alnibl/ESP32_cat_follower_robot/esp32_cat_follower_improved/README.md

# ESP32 Cat Follower Robot - Улучшенная версия v2.0

## 🎯 Что изменилось

Эта версия исправляет критические проблемы, найденные при тестировании:

### ❌ Проблемы в старой версии:
1. **Блокирующие задержки** - `delay(150)` при смене направления блокировал обработку новых команд
2. **Потеря команд backward** - команды терялись во время delay
3. **Высокая латентность** - до 1663 мс вместо нормальных 100 мс
4. **Мигание зеленого LED** - перегрузка WiFi из-за необработанных запросов

### ✅ Исправления в v2.0:
1. **Неблокирующие задержки** - используется проверка `millis()` вместо `delay()`
2. **Очередь команд** - до 5 команд могут быть сохранены, если ESP32 занят
3. **Детальное логирование** - статистика выполненных/потерянных команд
4. **Новый endpoint /stats** - мониторинг состояния в реальном времени

## 📊 Результаты тестирования

**Старая версия:**
- Success rate: 88.9% (4 failed из 36)
- Средняя латентность: 99 мс
- Пики латентности: до 1929 мс
- Команды backward пропускались

**Ожидаемые результаты v2.0:**
- Success rate: 95-100%
- Средняя латентность: 60-100 мс
- Пики латентности: <200 мс
- Все команды выполняются

## 🚀 Как загрузить прошивку

### Шаг 1: Откройте Arduino IDE

1. Запустите Arduino IDE (русский интерфейс)
2. Файл → Открыть
3. Выберите: `D:\Projects\ESP32_car_cat\esp32_cat_follower_improved\esp32_cat_follower_improved.ino`

### Шаг 2: Настройте параметры платы

**Инструменты (Tools) → Плата (Board):**
- Выберите: **ESP32S3 Dev Module**

**Инструменты → USB CDC On Boot:**
- Выберите: **Enabled** ⚠️ КРИТИЧНО!

**Инструменты → PSRAM:**
- Выберите: **OPI PSRAM**

**Инструменты → Flash Size:**
- Выберите: **8MB (64Mb)**

**Инструменты → Partition Scheme:**
- Выберите: **8M with spiffs (3.6MB APP/1.5MB SPIFFS)**

**Инструменты → Upload Speed:**
- Выберите: **921600** (или 115200 если есть проблемы)

**Инструменты → USB Mode:**
- Выберите: **Hardware CDC and JTAG**

### Шаг 3: Подключите ESP32

1. Подключите ESP32-S3 к компьютеру через USB-C порт (тот что помечен "COM")
2. **Инструменты → Порт (Port)** → Выберите COM порт (обычно COM3, COM4 и т.д.)

### Шаг 4: Загрузите прошивку

1. Нажмите кнопку **Загрузить** (стрелка →) в Arduino IDE
2. Дождитесь сообщения "Подключение..." в нижней части экрана

**Если загрузка не начинается автоматически:**
1. Нажмите и **удерживайте** кнопку **BOOT** на ESP32
2. Нажмите кнопку **RST** (один раз)
3. Отпустите **RST**, затем отпустите **BOOT**
4. Нажмите **Загрузить** в Arduino IDE ещё раз

### Шаг 5: Проверьте работу

1. После загрузки откройте **Монитор порта** (Инструменты → Монитор порта)
2. Установите скорость: **115200 baud**
3. Вы должны увидеть:

```
========================================
ESP32 Cat Follower Robot v2.0 - Starting...
IMPROVED VERSION - Non-blocking delays
========================================

Connecting to WiFi: TP-Link_571B
...
CONNECTED!
IP address: 192.168.0.112

Robot is ready!
========================================
```

4. Запишите IP адрес (например, 192.168.0.112)

## 🧪 Тестирование новой прошивки

### Тест 1: Проверка в браузере

Откройте браузер и перейдите по адресу: `http://192.168.0.112/`

Вы увидите веб-интерфейс с:
- Кнопками управления
- **Статистикой команд** (новое!)

Попробуйте:
1. Forward → Backward (быстро друг за другом)
2. Forward → Stop
3. Left → Right

**Ожидаемое поведение:**
- Все команды выполняются
- Плавная смена направления с паузой 150мс
- Нет пропусков команд

### Тест 2: Проверка статистики

Откройте: `http://192.168.0.112/stats`

Вы увидите JSON с:
```json
{
  "total_commands": 15,
  "executed": 15,
  "dropped": 0,
  "queue_size": 0,
  "current_state": "STOPPED",
  "waiting_for_change": false,
  "auto_stop_enabled": false
}
```

**Хорошие показатели:**
- `dropped`: 0 или очень малое число
- `queue_size`: 0-2 (не переполнена)
- `executed` ≈ `total_commands`

### Тест 3: Serial Monitor

В Serial Monitor вы увидите детальные логи:

```
⚠️  Direction change detected! Scheduling pause (150ms)...
STOP (immediate, before direction change)
Direction change delay completed, executing pending command
Moving BACKWARD @ 150 PWM (2 sec)
```

**Обратите внимание:**
- Сообщения о смене направления
- Команды не теряются
- Очередь работает если нужно

### Тест 4: Запуск motor_test_suite.py

```bash
cd D:\Projects\ESP32_car_cat
cat_env\Scripts\activate
python motor_test_suite.py
```

Выберите режим **5 (Фаза 5: Тесты последовательностей)**

**Ожидаемые результаты:**
- ✅ Test forward→backward: PASS
- ✅ Test emergency stop: PASS
- ✅ Test complex maneuvers: PASS
- Dropped commands: 0

## 📈 Мониторинг в реальном времени

### Через Serial Monitor

В Serial Monitor каждые 30 секунд выводится статистика:

```
========== STATISTICS ==========
Total commands received: 42
Executed commands: 42
Dropped commands: 0
Queue size: 0
Drop rate: 0.00%
================================
```

### Через Web интерфейс

Обновите главную страницу `http://192.168.0.112/`:
- **Total commands**: общее количество
- **Executed**: выполнено
- **Dropped**: потеряно
- **Queue**: размер очереди (0-5)

## 🔧 Новые возможности

### 1. Очередь команд

Если команды приходят быстрее чем ESP32 успевает их выполнить, они сохраняются в очередь (до 5 команд).

**Пример:**
```
Команда 1: forward → выполняется
Команда 2: backward → в очереди (ждет паузы 150мс)
Команда 3: left → в очереди
```

Когда пауза завершена, команды выполняются по порядку.

### 2. Endpoint /stats

**GET** `http://192.168.0.112/stats`

Возвращает JSON с текущим состоянием:
- Количество команд
- Состояние моторов
- Флаги ожидания
- Размер очереди

**Использование в Python:**
```python
import requests

response = requests.get("http://192.168.0.112/stats")
stats = response.json()

print(f"Dropped commands: {stats['dropped']}")
print(f"Current state: {stats['current_state']}")
```

### 3. Улучшенный /command endpoint

Теперь возвращает дополнительную информацию:

```json
{
  "status": "ok",
  "action": "forward",
  "speed": 150,
  "queue": 0,
  "dropped": 0
}
```

## ⚠️ Важные примечания

1. **Не удаляйте старую версию** - держите `esp32_cat_follower_simple` как backup
2. **WiFi настройки** - проверьте SSID и пароль в строках 12-13
3. **Пины** - не меняйте GPIO пины без необходимости
4. **Serial Monitor** - используйте для диагностики проблем

## 🐛 Решение проблем

### Команды все равно теряются

Проверьте в Serial Monitor:
```
⚠️  Command queue FULL! Dropping command.
```

**Решение:** Увеличьте `COMMAND_QUEUE_SIZE` в коде (строка 40):
```cpp
const int COMMAND_QUEUE_SIZE = 10;  // Было 5
```

### Высокая латентность

Проверьте `/stats`:
- Если `queue_size` часто = 5 → очередь переполняется
- Если `waiting_for_change` = true долгое время → проблема с таймером

**Решение:** Уменьшите частоту команд в Python (увеличьте `COMMAND_INTERVAL`)

### ESP32 перезагружается

Проверьте питание:
- PowerBank должен выдавать **минимум 2A**
- Проверьте все GND подключения
- Убедитесь что конденсаторы припаяны к повышающему преобразователю

## 📊 Сравнение версий

| Параметр | v1.0 (старая) | v2.0 (новая) |
|---|---|---|
| Блокирующие delay | ✅ Да (150мс) | ❌ Нет |
| Очередь команд | ❌ Нет | ✅ Да (5 команд) |
| Статистика | ❌ Нет | ✅ Да |
| Success rate | 88.9% | 95-100% (ожидается) |
| Потеря backward | ✅ Да | ❌ Нет |
| Endpoint /stats | ❌ Нет | ✅ Да |
| Логирование | Базовое | Детальное |

## 🎉 Что дальше?

После успешной загрузки v2.0:

1. **Запустите полный тест:**
   ```bash
   python motor_test_suite.py
   # Выберите режим 1 (Полный набор)
   ```

2. **Сравните результаты** с предыдущим отчетом:
   - Success rate должен быть >95%
   - Dropped commands ≈ 0
   - Все тесты последовательностей PASS

3. **Запустите cat_follower_yolo11.py** для тестирования с реальным котом!

---

**Версия:** 2.0
**Дата:** 2025-12-02
**Автор:** Улучшения на основе анализа отчета тестирования
