alnibl/ESP32_cat_follower_robot/esp32_cat_follower_improved/UPDATE_WEB_INTERFACE.md

# Обновление веб-интерфейса v2.1

## 🎯 Что изменилось

Заменен старый веб-интерфейс со ссылками на **современный с AJAX кнопками**!

### Проблема (старая версия):
```
❌ Нажимаете "Move Forward" → страница перезагружается
❌ Показывается только текст "Moving forward"
❌ Нужно нажимать "Назад" в браузере
❌ Невозможно быстро отправлять команды
```

### Решение (новая версия):
```
✅ Нажимаете кнопку → команда отправляется БЕЗ перезагрузки
✅ Страница остается открытой
✅ Статистика обновляется автоматически каждые 2 секунды
✅ Можно быстро нажимать команды подряд!
```

---

## 🚀 Новые возможности

### 1. **AJAX кнопки** (без перезагрузки страницы)
- Кнопки используют JavaScript `fetch()` API
- Отправляют запросы на `/command?action=forward&speed=150`
- Страница НЕ перезагружается!

### 2. **Live обновление статистики**
- Статистика обновляется каждые 2 секунды автоматически
- Не нужно обновлять страницу (F5)
- Видите изменения в реальном времени!

### 3. **Визуальная обратная связь**
```
✅ Sent: FORWARD @ 150 PWM
```
После каждой команды показывается подтверждение.

### 4. **Современный дизайн**
- Крупные цветные кнопки
- Grid layout (3x3) для удобства
- Эмодзи для каждой команды:
  - ⬆️ Forward (зеленая)
  - ⬇️ Backward (красная)
  - ⬅️ Left (оранжевая)
  - ➡️ Right (синяя)
  - ⏹️ Stop (серая)

### 5. **Адаптивный дизайн**
- Работает на телефоне и планшете
- Responsive layout (max-width: 600px)
- Viewport meta tag для мобильных устройств

---

## 📸 Как выглядит новый интерфейс

```
╔════════════════════════════════════════╗
║  🤖 ESP32 Cat Robot v2.1               ║
║  ✅ BUGFIX: Queue processing fixed!    ║
║  IP: 192.168.0.112 | Speed: 150 PWM   ║
║                                        ║
║  Ready to control...                   ║
║                                        ║
║  ┌──────────┬──────────┬──────────┐   ║
║  │          │ ⬆️       │          │   ║
║  │          │ Forward  │          │   ║
║  │          │ (1.5s)   │          │   ║
║  ├──────────┼──────────┼──────────┤   ║
║  │ ⬅️       │          │ ➡️       │   ║
║  │ Left     │          │ Right    │   ║
║  │ (0.4s)   │          │ (0.4s)   │   ║
║  ├──────────┼──────────┼──────────┤   ║
║  │          │ ⬇️       │          │   ║
║  │          │ Backward │          │   ║
║  │          │ (1.5s)   │          │   ║
║  ├──────────┴──────────┴──────────┤   ║
║  │      ⏹️ STOP                   │   ║
║  └─────────────────────────────────┘   ║
║                                        ║
║  📊 Statistics (Auto-refresh)          ║
║  Total commands: 15                    ║
║  ├─ Executed: 15                       ║
║  ├─ Queued: 10                         ║
║  ├─ Dropped: 0 ✅                      ║
║  └─ In queue now: 0/5                  ║
║  Motor state: STOPPED                  ║
╚════════════════════════════════════════╝
```

---

## 🔄 Как обновить прошивку

### Шаг 1: Загрузите обновленную прошивку

```
1. Arduino IDE → Открыть:
   D:\Projects\ESP32_car_cat\esp32_cat_follower_improved\esp32_cat_follower_improved.ino

2. Настройки платы (как обычно):
   - ESP32S3 Dev Module
   - USB CDC On Boot: Enabled

3. Загрузить (стрелка →)
```

### Шаг 2: Откройте новый интерфейс

```
1. Откройте браузер: http://192.168.0.112/

2. Вы увидите новый интерфейс с кнопками!
```

### Шаг 3: Протестируйте

```
Быстро нажмите несколько команд подряд:
1. Forward
2. Left
3. Forward
4. Right
5. Stop

Страница НЕ перезагружается!
Статистика обновляется автоматически!
```

---

## 🧪 Как работают AJAX кнопки

### Техническое описание:

```javascript
// При нажатии кнопки:
function sendCommand(action) {
  // 1. Отправляем запрос БЕЗ перезагрузки страницы
  fetch('/command?action=' + action + '&speed=150')
    .then(r => r.json())
    .then(data => {
      // 2. Показываем подтверждение
      document.getElementById('lastCommand').textContent =
        '✅ Sent: ' + action.toUpperCase();

      // 3. Обновляем статистику
      updateStats();
    });
}

// Автоматическое обновление статистики каждые 2 секунды:
setInterval(updateStats, 2000);
```

### Преимущества:
- ✅ Страница остается открытой
- ✅ Можно быстро нажимать команды
- ✅ Видите результаты в реальном времени
- ✅ Работает как мобильное приложение!

---

## 📊 Сравнение старого и нового интерфейса

| Функция | Старый (ссылки) | Новый (AJAX кнопки) |
|---|---|---|
| **Перезагрузка страницы** | ❌ Да (каждый раз) | ✅ Нет |
| **Быстрые команды** | ❌ Невозможно | ✅ Да |
| **Обновление статистики** | ❌ Вручную (F5) | ✅ Авто (2 сек) |
| **Визуальная обратная связь** | ❌ Нет | ✅ Да |
| **Дизайн** | ❌ Простой список | ✅ Крупные кнопки |
| **Мобильная версия** | ❌ Нет | ✅ Да |
| **Цветовая индикация** | ❌ Нет | ✅ Да |
| **Эмодзи** | ⚠️ Частично | ✅ Везде |

---

## 🎯 Тестирование очереди команд (теперь легко!)

### Быстрый тест очереди:

```
1. Откройте: http://192.168.0.112/

2. БЫСТРО нажмите (без пауз):
   - Forward
   - Forward
   - Left
   - Right
   - Stop

3. Наблюдайте за статистикой в реальном времени!

   Вы увидите как:
   - Total commands увеличивается
   - Queued растет (команды добавляются в очередь)
   - In queue now меняется (очередь обрабатывается)
   - Dropped остается 0 ✅
```

### Ожидаемый результат:

```
📊 Statistics (Auto-refresh)
Total commands: 5
├─ Executed: 5
├─ Queued: 4        ← 4 команды попали в очередь!
├─ Dropped: 0 ✅    ← Нет потерь!
└─ In queue now: 0/5 ← Все выполнено
Motor state: STOPPED
```

**Теперь вы можете легко протестировать очередь!** 🎉

---

## 🐛 Возможные проблемы

### Проблема 1: Старый интерфейс всё ещё показывается

**Причина:** Браузер кэширует старую HTML страницу.

**Решение:**
```
1. Очистите кэш браузера:
   - Chrome/Edge: Ctrl+Shift+Delete
   - Или просто: Ctrl+F5 (жесткое обновление)

2. Или откройте в режиме инкогнито:
   - Chrome/Edge: Ctrl+Shift+N
```

### Проблема 2: Кнопки не отправляют команды

**Причина:** JavaScript отключен или ошибка в консоли.

**Решение:**
```
1. Откройте консоль браузера: F12
2. Перейдите на вкладку "Console"
3. Посмотрите есть ли ошибки (красным цветом)
4. Если есть - пришлите скриншот
```

### Проблема 3: Статистика не обновляется автоматически

**Причина:** Endpoint `/stats` не отвечает.

**Решение:**
```
1. Проверьте вручную: http://192.168.0.112/stats
2. Должен вернуться JSON
3. Если нет - проверьте Serial Monitor
```

---

## 📱 Использование с телефона/планшета

Новый интерфейс отлично работает на мобильных устройствах!

### Как подключиться:

```
1. Убедитесь что телефон подключен к той же WiFi сети
   (TP-Link_571B)

2. Откройте браузер на телефоне

3. Введите: http://192.168.0.112/

4. Добавьте на главный экран (опционально):
   - Android Chrome: Меню → "Добавить на главный экран"
   - iOS Safari: Поделиться → "На экран Домой"

5. Теперь можно управлять роботом с телефона!
```

### Преимущества мобильного управления:

- ✅ Ходите с телефоном рядом с роботом
- ✅ Крупные кнопки удобны для пальцев
- ✅ Видите статистику в реальном времени
- ✅ Не нужен ноутбук!

---

## 🎯 Следующие шаги

После обновления интерфейса:

1. **Протестируйте очередь команд:**
   ```
   Быстро нажмите 5-10 команд подряд
   Проверьте что Queued > 0
   Проверьте что Dropped = 0
   ```

2. **Запустите полное тестирование:**
   ```bash
   python motor_test_suite.py
   ```

3. **Попробуйте управление с телефона:**
   ```
   Откройте http://192.168.0.112/ на телефоне
   Ходите с роботом, управляя с телефона!
   ```

4. **Запустите мониторинг:**
   ```bash
   python monitor_stats.py
   ```
   На ноутбуке будет live статистика, пока вы управляете с телефона!

---

## ✨ Бонус: Горячие клавиши (планируется в v2.2)

В будущей версии можно добавить управление с клавиатуры:

```javascript
// Пример (не реализовано пока):
document.addEventListener('keydown', (e) => {
  if (e.key === 'ArrowUp') sendCommand('forward');
  if (e.key === 'ArrowDown') sendCommand('backward');
  if (e.key === 'ArrowLeft') sendCommand('left');
  if (e.key === 'ArrowRight') sendCommand('right');
  if (e.key === ' ') sendCommand('stop');
});
```

Если нужно - скажите, добавлю!

---

**Обновляйте прошивку и наслаждайтесь удобным интерфейсом!** 🚀

Теперь вы можете быстро тестировать очередь команд без необходимости нажимать "Назад" в браузере!
