alnibl/ESP32_cat_follower_robot/BENCHMARK_GUIDE.md

# Руководство по бенчмарку YOLO11 на Intel i5-1235U

## Зачем нужен бенчмарк?

Ваш процессор **Intel i5-1235U** поддерживает технологию **OpenVINO** - оптимизацию для нейронных сетей от Intel.

**OpenVINO может ускорить YOLO11 в 1.5-3 раза** на процессорах Intel!

---

## Что делает скрипт benchmark_models.py?

1. **Захватывает 50 кадров** с вашей IP камеры
2. **Тестирует PyTorch модель** (yolo11n.pt) - стандартная версия
3. **Экспортирует в OpenVINO** - конвертирует модель в формат для Intel процессоров
4. **Тестирует OpenVINO модель** - оптимизированная версия
5. **Сравнивает результаты** - показывает какая модель быстрее

---

## Как запустить бенчмарк?

### Шаг 1: Установить OpenVINO

```bash
# Активировать окружение
source cat_env/Scripts/activate

# Установить OpenVINO
pip install openvino
```

### Шаг 2: Настроить config.py

Убедитесь что указан правильный CAMERA_URL:

```python
CAMERA_URL = "rtsp://192.168.0.162:554/stream"  # ← Ваша камера
```

### Шаг 3: Запустить бенчмарк

```bash
python benchmark_models.py
```

---

## Что вы увидите?

### Вывод в консоли:

```
🏁 БЕНЧМАРК: YOLO11 PyTorch vs OpenVINO
============================================================

Процессор: Intel i5-1235U
Модель: yolo11n.pt
Разрешение: 640x480
Количество тестовых кадров: 50

📹 Подключение к камере: rtsp://192.168.0.162:554/stream
✅ Камера подключена!

📸 Захват 50 тестовых кадров...
   Захвачено 10/50 кадров
   Захвачено 20/50 кадров
   ...
✅ Захвачено 50 кадров

============================================================
🧪 Тестирование: YOLO11 PyTorch (.pt)
============================================================
⏳ Загрузка модели: yolo11n.pt
✅ Модель загружена успешно!
🔥 Прогрев модели (5 кадров)...
⚡ Запуск бенчмарка на 50 кадрах...
   Кадр 10/50 | Время: 118.5мс | FPS: 8.4
   Кадр 20/50 | Время: 117.2мс | FPS: 8.5
   ...

============================================================
📊 РЕЗУЛЬТАТЫ: YOLO11 PyTorch (.pt)
============================================================
  Обработано кадров:        50
  Общее время:              5.88 сек
  Детектировано котов:      12

  Среднее время инференса:  117.60 мс
  Минимальное время:        112.30 мс
  Максимальное время:       125.40 мс
  Стандартное отклонение:   3.50 мс

  ⚡ Средний FPS:            8.50 fps
============================================================

============================================================
🔄 ЭКСПОРТ В OPENVINO
============================================================
⏳ Загрузка модели: yolo11n.pt
⏳ Экспорт в формат OpenVINO...
   (Это может занять 1-2 минуты при первом запуске)
✅ Экспорт завершён успешно!
📁 Путь к модели OpenVINO: yolo11n_openvino_model
============================================================

============================================================
🧪 Тестирование: YOLO11 OpenVINO
============================================================
⏳ Загрузка модели: yolo11n_openvino_model
✅ Модель загружена успешно!
🔥 Прогрев модели (5 кадров)...
⚡ Запуск бенчмарка на 50 кадрах...
   Кадр 10/50 | Время: 66.2мс | FPS: 15.1
   Кадр 20/50 | Время: 65.5мс | FPS: 15.3
   ...

============================================================
📊 РЕЗУЛЬТАТЫ: YOLO11 OpenVINO
============================================================
  Обработано кадров:        50
  Общее время:              3.29 сек
  Детектировано котов:      12

  Среднее время инференса:  65.80 мс
  Минимальное время:        62.10 мс
  Максимальное время:       71.20 мс
  Стандартное отклонение:   2.20 мс

  ⚡ Средний FPS:            15.20 fps
============================================================

============================================================
📊 СРАВНЕНИЕ РЕЗУЛЬТАТОВ
============================================================

Модель                    FPS            Время (мс)
------------------------------------------------------------
PyTorch (.pt)             8.50           117.60
OpenVINO                  15.20          65.80
------------------------------------------------------------

⚡ Ускорение OpenVINO:      1.79x
⏱️  Снижение времени:       44.0%

============================================================
💡 РЕКОМЕНДАЦИЯ
============================================================
✅ OpenVINO значительно быстрее (1.79x)!
   Рекомендуется использовать для вашего робота.

   Обновите config.py:
   YOLO_MODEL = "yolo11n_openvino_model"
============================================================
```

---

## Как использовать результаты?

### Если OpenVINO быстрее (обычно так и есть):

1. Откройте `config.py`
2. Измените строку:

```python
# Было:
YOLO_MODEL = "yolo11n.pt"

# Стало (используйте путь из вывода бенчмарка):
YOLO_MODEL = "yolo11n_openvino_model"
```

3. Теперь все скрипты будут использовать быструю OpenVINO версию!

---

## Типичные результаты на Intel i5-1235U

### Ожидаемое ускорение:

| Модель | FPS (640x480) | Время инференса |
|---|---|---|
| PyTorch (.pt) | 7-10 fps | 100-140 мс |
| OpenVINO | 12-18 fps | 55-80 мс |
| **Ускорение** | **1.5-2.0x** | **30-50% быстрее** |

---

## Решение проблем

### Ошибка: "openvino not found"

```bash
pip install openvino
```

### Ошибка при экспорте: "Permission denied"

Запустите VS Code от имени администратора или измените папку проекта.

### Низкий FPS на обеих моделях (<5 fps)

1. Уменьшите разрешение в config.py:
   ```python
   FRAME_WIDTH = 416
   FRAME_HEIGHT = 416
   ```

2. Закройте другие программы

3. Проверьте что камера даёт хороший поток (10 FPS)

---

## После бенчмарка

Теперь можете запускать робота с оптимизированной моделью:

```bash
# Тест детекции
python test_detection.py

# Полный запуск
python cat_follower_yolo11.py
```

Модель из `YOLO_MODEL` в config.py будет использоваться автоматически!

---

## Дополнительная оптимизация

### Если хотите ещё больше скорости:

1. **Уменьшите разрешение**:
   ```python
   FRAME_WIDTH = 416
   FRAME_HEIGHT = 416
   ```

2. **Используйте INT8 квантизацию** (для продвинутых):
   ```python
   model.export(format='openvino', int8=True)
   ```

3. **Уменьшите confidence threshold** (меньше обработки):
   ```python
   CONFIDENCE_THRESHOLD = 0.6  # было 0.5
   ```

---

**Удачи с бенчмарком! 🚀**
