alnibl/ESP32_cat_follower_robot/TEST_REPORT_20251202_171003.md

# Отчет о тестировании моторов ESP32
## Робот следящий за котом

**Дата/Время:** 2025-12-02 17:29:44
**Session ID:** 20251202_171003
**ESP32 IP:** 192.168.0.112

---

## 📊 Сводка результатов

| Метрика | Значение |
|---|---|
| **Всего тестов** | 36 |
| **Успешно** | 32 (88.9%) |
| **Провалено** | 4 |

---

## 🎯 Рекомендации для config.py

На основе проведенных тестов рекомендуется обновить следующие параметры:

```python
# ========== РЕЗУЛЬТАТЫ КАЛИБРОВКИ ==========
# Calibration Results from motor_test_suite.py
# Дата тестирования: 2025-12-02

# Рекомендуемые скорости (проверены тестами):
SPEED_FORWARD_FAST = 200   # ✅ Стабильно
SPEED_FORWARD_SLOW = 150   # ✅ Плавно
SPEED_TURN_FAST = 200
SPEED_TURN_SLOW = 150
SPEED_SEARCH = 180
SPEED_BACKWARD = 200

# Минимальный безопасный интервал между командами:
COMMAND_INTERVAL = 0.7     # ✅ Протестировано
```

---

## 📁 Файлы с результатами

- **CSV данные:** test_results_20251202_171003.csv
- **JSON отчет:** test_report_20251202_171003.json

---

**Дата отчета:** 2025-12-02
**Генератор:** Motor Test Suite v1.0
