alnibl/ESP32_cat_follower_robot/test_results_20251202_171003.csv

timestamp | category | phase | direction | speed_pwm | duration_target_ms | duration_actual_ms | latency_ms | success | moved | distance_cm | quality_score | notes | test_id
2025-12-02T17:10:03.860711 | connection | 1 | N/A | 0 | 0 | 0 | 359.26 | True | N/A | N/A | N/A | ESP32 responded with HTTP 200 | 1
2025-12-02T17:11:33.599433 | pwm_calibration | 1 | forward | 115 | 1000 | 2000 | 0 | True | True | N/A | N/A | Minimum PWM found: 115 | 2
2025-12-02T17:11:37.642562 | latency | 2 | N/A | 0 | 0 | 0 | 96.67 | False | N/A | N/A | N/A | Network RTT: avg=96.67ms, min=69.47ms, max=132.45ms | 3
2025-12-02T17:11:41.749923 | latency | 2 | N/A | 0 | 0 | 0 | 101.33 | True | N/A | N/A | N/A | Command latency: avg=101.33ms, success_rate=100.0% | 4
2025-12-02T17:13:56.996825 | latency | 2 | forward | 200 | 0 | 0 | 0 | False | False | N/A | N/A | No data collected | 5
2025-12-02T17:15:19.128241 | duration | 3 | forward | 150 | 250 | 2000 | 107.41 | True | True | 0 | 5 |  | 6
2025-12-02T17:16:07.705295 | duration | 3 | forward | 150 | 500 | 2000 | 312.95 | True | True | 0 | 5 |  | 7
2025-12-02T17:16:44.002007 | duration | 3 | forward | 150 | 750 | 2000 | 88.9 | True | True | 30.0 | 5 | 5 | 8
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
