alnibl/ESP32_cat_follower_robot/test_results_20251202_181247.csv

timestamp | category | phase | direction | speed_pwm | duration_target_ms | duration_actual_ms | latency_ms | success | moved | distance_cm | quality_score | notes | test_id
2025-12-02T18:12:47.405457 | connection | 1 | N/A | 0 | 0 | 0 | 342.27 | True | N/A | N/A | N/A | ESP32 responded with HTTP 200 | 1
2025-12-02T18:14:54.070755 | pwm_calibration | 1 | forward | 136 | 1000 | 2000 | 0 | True | True | N/A | N/A | Minimum PWM found: 136 | 2
2025-12-02T18:14:58.217798 | latency | 2 | N/A | 0 | 0 | 0 | 102.03 | False | N/A | N/A | N/A | Network RTT: avg=102.03ms, min=81.68ms, max=131.99ms | 3
2025-12-02T18:15:02.302149 | latency | 2 | N/A | 0 | 0 | 0 | 97.87 | True | N/A | N/A | N/A | Command latency: avg=97.87ms, success_rate=100.0% | 4
2025-12-02T18:16:53.881401 | latency | 2 | forward | 200 | 0 | 0 | 500.0 | True | True | N/A | N/A | Motor response time (visual): avg=500.0ms | 5
2025-12-02T18:17:04.899824 | duration | 3 | forward | 150 | 250 | 2000 | 115.94 | False | False | 0 | 0 | Робот не двигался | 6
2025-12-02T18:17:30.976390 | duration | 3 | forward | 150 | 500 | 2000 | 62.75 | True | True | 40.0 | 4 |  | 7
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
