alnibl/ESP32_cat_follower_robot/FIX_TIMING.md

# Исправление проблемы с таймингом команд

## Проблема

Робот "пищал" и стоял на месте, потому что:

1. **Команды отправлялись слишком часто** (каждые 300мс)
2. **ESP32 не успевал выполнять команды** (таймеры на 500мс)
3. **Компенсация дрейфа мешала** (скорость 18 = 7% от макс - мотор не запускался)

### Что происходило:

```
0мс:    Команда RIGHT (компенсация, скорость 18) → ESP32 начал таймер 500мс
300мс:  Команда FORWARD (скорость 120) → ESP32 прервал предыдущую, начал новый таймер
600мс:  Команда LEFT (поиск) → ESP32 прервал, новый таймер
...
```

**Результат:** Моторы постоянно прерывались, робот пищал (команды приходили) но не двигался.

---

## Решение

### 1. Отключена компенсация дрейфа (временно)

```python
# config.py
DRIFT_COMPENSATION = 0.0  # было 0.15
```

**Почему:** Упрощает логику, убирает лишние команды

---

### 2. Увеличен интервал команд

```python
# config.py
COMMAND_INTERVAL = 0.7  # было 0.3
```

**Почему:**
- ESP32 имеет таймеры на 500мс
- Нужен запас времени для выполнения команды
- 700мс = 500мс на выполнение + 200мс запас

---

### 3. Упрощён режим поиска

**Было:**
```
Цикл 3 секунды:
- 1 сек: поворот
- 1 сек: пауза
- 1 сек: вперёд
```

**Стало:**
```
Всё время: медленный поворот на месте
```

**Почему:** Проще, стабильнее, робот просто крутится пока не найдёт кота

---

## Новый алгоритм работы

### Временная диаграмма:

```
Время:      0с      0.7с    1.4с    2.1с    2.8с
Кадр:       #1      #3      #5      #7      #9
Обработка:  ✅      ✅      ✅      ✅      ✅
Команда:    LEFT → ESP32 → STOP → LEFT → LEFT
            ↓      выполняет     ↓      ↓
           500мс   команду     500мс  500мс
           поворот             поворот
```

**Робот:**
1. Детектирует кота каждые ~200мс (каждый 2-й кадр)
2. Принимает решение
3. Отправляет команду ESP32 **раз в 700мс**
4. ESP32 **успевает выполнить** команду за 500мс
5. Через 700мс приходит следующая команда

---

## Что должно работать теперь

### Режим поиска (кота нет):
- Робот медленно поворачивается влево/вправо
- Каждые 3 секунды меняет направление
- Команды идут каждые 700мс
- Нет рывков, плавное вращение

### Когда кот найден:
```
🐱 Кот детектирован! Размер bbox: 191x268
↔️  Кот на оптимальном расстоянии но сбоку (отклонение 222px)
📡 Команда отправлена: right (скорость: 150)
   ↓
ESP32 поворачивает вправо 500мс
   ↓
700мс спустя → следующая команда
```

---

## Параметры для тонкой настройки

### Если робот слишком медленно реагирует:

```python
COMMAND_INTERVAL = 0.6  # Быстрее (минимум 0.6 сек!)
```

### Если робот дёргается:

```python
COMMAND_INTERVAL = 0.8  # Медленнее, плавнее
```

### Если хотите вернуть режим патруля (вперёд + поворот):

Откатите изменения в `cat_follower_yolo11.py` функции `search_mode()`

---

## Важно!

**Не делайте COMMAND_INTERVAL меньше 0.6 секунды!**

Иначе команды будут снова прерывать друг друга:
- ESP32 таймер = 500мс
- Нужен запас = минимум 100мс
- Итого минимум = 600мс = 0.6 сек

---

## Тестирование

Запустите снова:

```bash
python cat_follower_yolo11.py
```

**Ожидаемое поведение:**

1. **Без кота:**
   - Робот медленно крутится на месте
   - Раз в 700мс слышен короткий "пи" (команда отправлена)
   - Видно плавное вращение

2. **С котом:**
   - Робот поворачивается к коту
   - Едет вперёд если кот далеко
   - Останавливается на оптимальном расстоянии
   - Движения плавные, без рывков

---

## Следующие улучшения

После того как всё заработает стабильно, можно:

1. **Вернуть компенсацию дрейфа** (но с бОльшим коэффициентом ~0.5)
2. **Добавить плавное ускорение** (постепенно увеличивать скорость)
3. **Сглаживание детекций** (усреднять положение кота за несколько кадров)

Но сначала - стабильная базовая работа! 🎯
