alnibl/ESP32_cat_follower_robot/test_detection.py

"""
Тестовый скрипт для проверки детекции кота с YOLO11
Test script for cat detection with YOLO11 (no motor control)
"""

from cat_follower_yolo11 import CatFollowerYOLO11

if __name__ == "__main__":
    print("\n" + "="*60)
    print("🧪 ТЕСТОВЫЙ РЕЖИМ: Проверка детекции YOLO11")
    print("="*60)
    print("\nЭтот скрипт:")
    print("  ✅ Подключается к камере")
    print("  ✅ Детектирует кота с помощью YOLO11")
    print("  ✅ Показывает видео с bbox и информацией")
    print("  ❌ НЕ управляет моторами ESP32")
    print("\nИспользуйте этот режим для:")
    print("  • Проверки что YOLO правильно детектирует кота")
    print("  • Проверки качества видео с камеры")
    print("  • Проверки FPS обработки")
    print("\n" + "="*60 + "\n")

    # Создание робота
    robot = CatFollowerYOLO11()

    # Запуск только детекции (без управления моторами)
    robot.test_detection_only()
