alnibl/ESP32_cat_follower_robot/(commit log)

2025-12-03 Initial commit: ESP32 Cat Follower Robot with YOLO11
    [test_results_20251202_171003.csv, test_results_20251202_181247.csv]
2025-12-03 Add quick Test #30 verification script - v2.1 queue bug fixed
    [quick_test_30.py]
2025-12-09 Fix: Stabilize robot movement with fixed support wheel
    ## Hardware Changes:
    - Fixed front support wheel in place to prevent drift during forward/backward movement
    - Solution: Physical wheel fixation replaces software stabilization attempts
    ## Firmware Changes (esp32_cat_follower_improved.ino):
    - Removed stabilization logic (forward impulse after turns) - no longer needed
    - Added separate turn speed: turnSpeed = 230 PWM (increased for fixed wheel)
    - Standard movement speed: motorSpeed = 150 PWM (forward/backward)
    - Restored non-blocking timer-based logic from v2.1
    ## Documentation:
    - Added robot photos section to README.md (3 images)
    - Added images/ folder with robot photos:
    - robot_overv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
    [esp32_cat_follower_improved.ino]
2025-12-11 Feat: Add tank turn for faster, sharper turning
    - Turn left: left wheel backward + right wheel forward
    - Turn right: left wheel forward + right wheel backward
    - Turn duration: 400ms → 300ms
    - Web UI: fixed speed for turns (230 PWM)
    [esp32_cat_follower_improved.ino]
