alnibl/ESP32_cat_follower_robot/(notices)

Notices in the files:
README.md:
License: MIT
